abhinavb03/SmartGlasses/TP4056 Charging Module.jpg

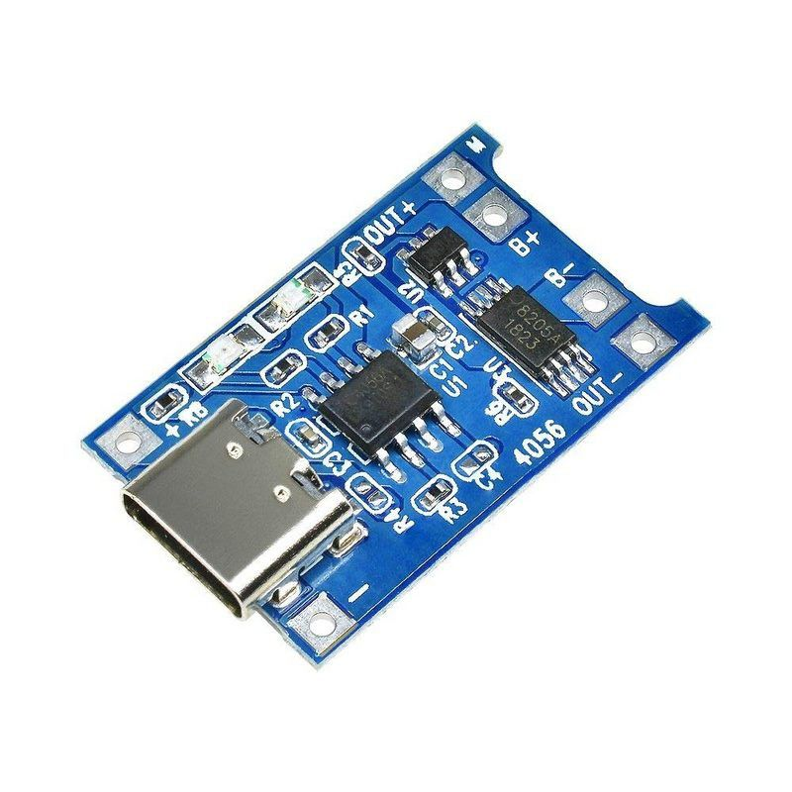
TP4056 Charging Module.jpg
