abhinavb03/SmartGlasses/Sparkfun ESP32 Thing Plus.jpg

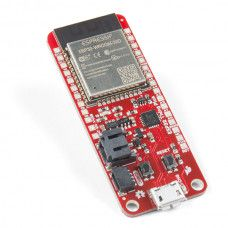
Sparkfun ESP32 Thing Plus.jpg
