abhinavb03/SmartGlasses/Fusion 360.png

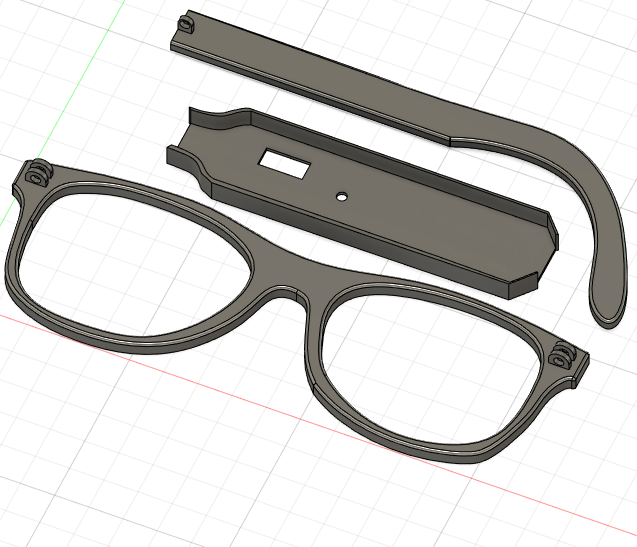
Fusion 360.png
