abhinavb03/SmartGlasses/LiPo Battery.jpg

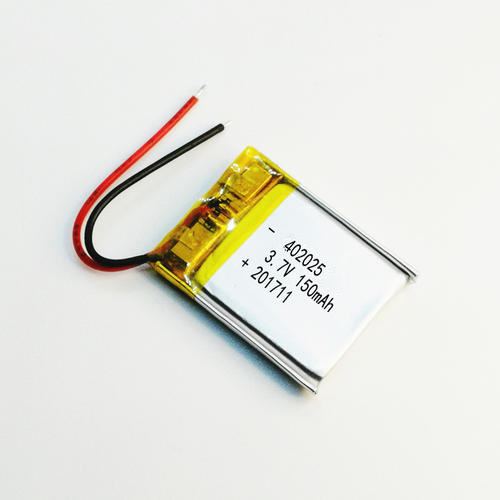
LiPo Battery.jpg
