abhinavb03/SmartGlasses/Slideswitch.webp

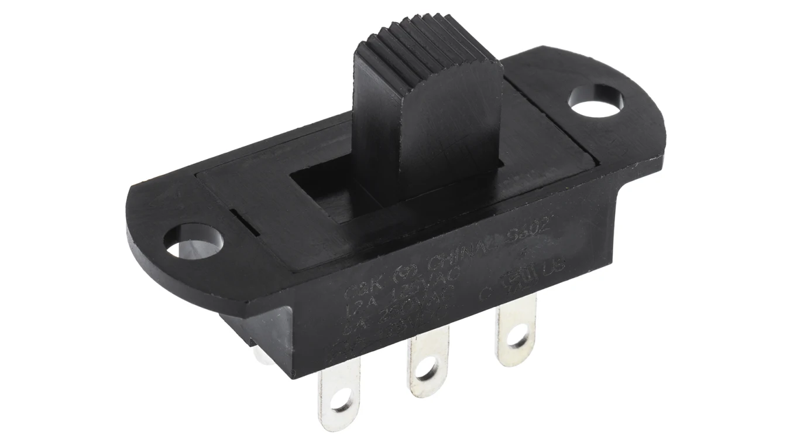
Slideswitch.webp
