abhinavb03/SmartGlasses/Smartglasses Circuit.jpg

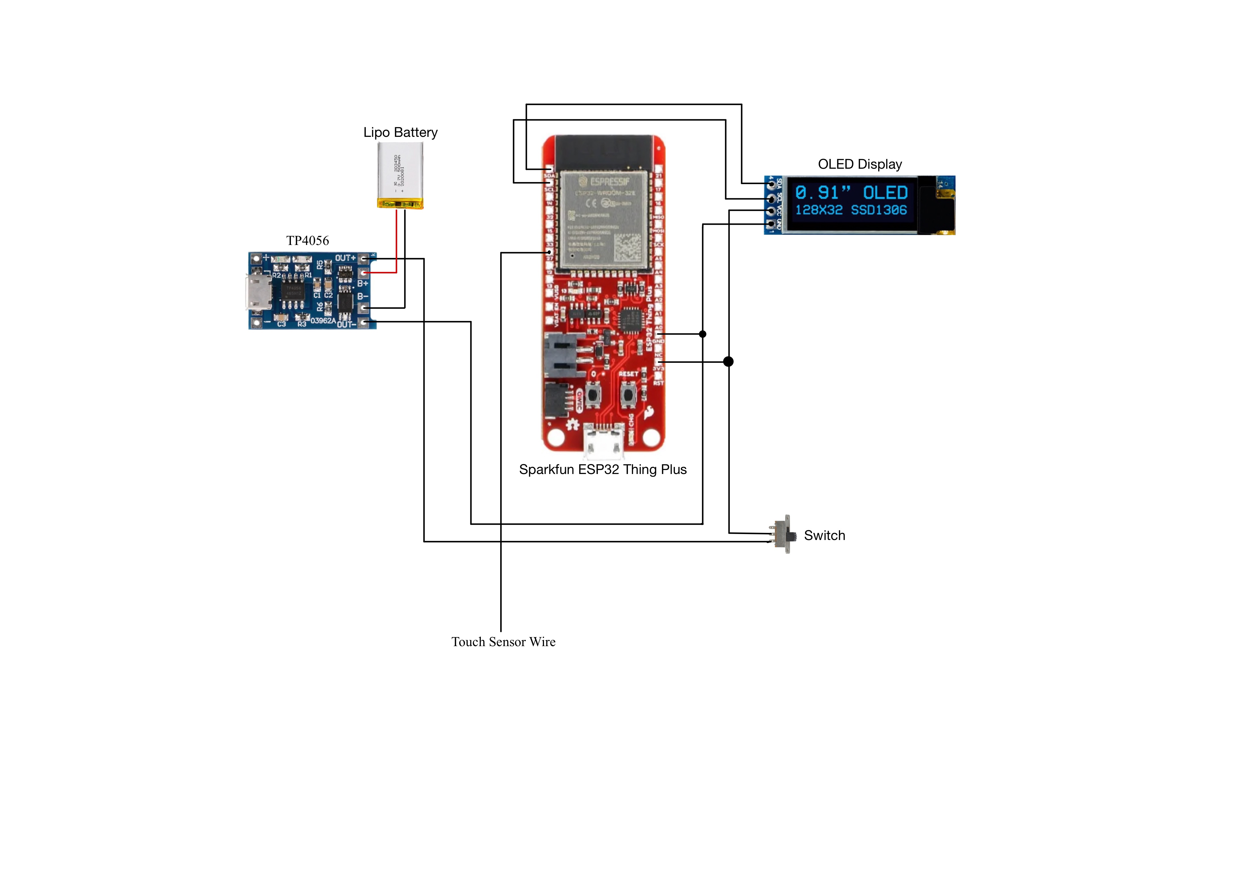
Smartglasses Circuit.jpg
